Llamero/MHz_LED_Modulator_v2/MHz_LED_Driver_Software/Master list of packet data labels.txt

1-9: System identifiers
1 - ID packet
2 - temperature packet
3 - panel interface packet
4 - waveform packet

Temperature packet
byte 1 - input temp
byte 2 - output temp
byte 3 - external temp
byte 4 - Overheat state

Panel interface packet
byte 1 - potentiometer
byte 2 - toggle switch

Waveform packet
byte[] - recorded waveform

260
