Llamero/MHz_LED_Modulator_v2/Design files/Schematic.png

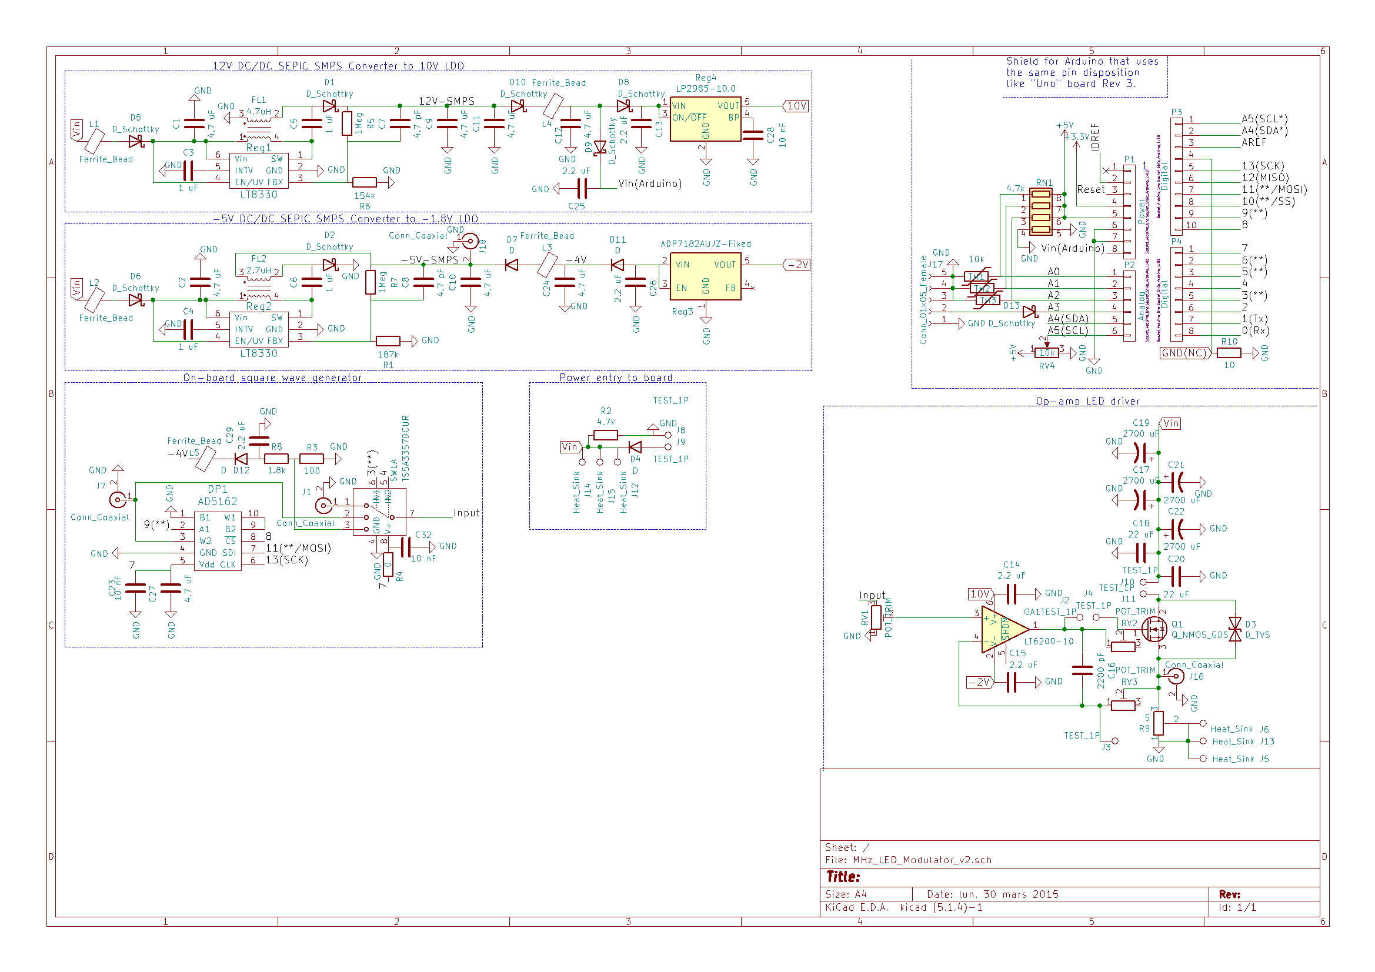
Design files/Schematic.png
