Llamero/MHz_LED_Modulator_v2/Design files/MHz_LED_Modulator_v2/MHz_LED_Modulator_v2.xlsx

Reference | Value | Footprint | Datasheet | Manufacturer | Manufacturer Part # | Digikey Part # | Count | NOTE:
J20 | GND_bolt | Wire_Pads:SolderWirePad_single_1-2mmDrill
R8 | 1.8k | Resistors_SMD:R_0603 | http://www.yageo.com/documents/recent/PYu-RT_1-to-0.01_RoHS_L_9.pdf | Yageo | RT0603DRE071K8L | 311-2472-1-ND | 1 | Â±50ppm/Â°C 0.1W Â±0.5%
C23, C28, C32 | 10 nF | Capacitors_SMD:C_0805 | http://www.samsungsem.com/kr/support/product-search/mlcc/__icsFiles/afieldfile/2016/09/21/Data%20sheet_CL21B103KDCNNNC.pdf | Samsung Electro-Mechanics | CL21B103KDCNNNC | 1276-1170-1-ND | 3 | 250V - 50MOhm resistance
D1, D2 | D_Schottky | Diodes_SMD:D_SOD-323F | https://assets.nexperia.com/documents/data-sheet/PMEG6010CEH_PMEG6010CEJ.pdf | Nexperia USA Inc. | PMEG6010CEJ,115 | 1727-3882-1-ND | 2 | Recommended
D7, D11, D12 | D | Diodes_SMD:D_SOD-323F | https://assets.nexperia.com/documents/data-sheet/BAS16_SER.pdf | Nexperia USA Inc. | BAS16J,135 | 1727-4797-1-ND | 3 | 1.25V max @ 150mA - 4ns recovery
SW1 | TS5A3357DCUR | Ben_Custom:8-VFSOP | http://www.ti.com/lit/ds/symlink/ts5a3357.pdf | Texas Instruments | TS5A3357DCUR | 296-17404-1-ND | 1 | 15 Ohm - 6.5ns switch time
Reg4 | LP2985-10.0 | TO_SOT_Packages_SMD:SOT-23-5 | http://www.ti.com/lit/ds/symlink/lp2985.pdf | Texas Instruments | LP2985-10DBVR | 296-24263-1-ND | 1 | 10V fixed - 150mA max - PSRR 45dB (1kHz)
TH1, TH2, TH3 | 10k | Ben_Custom:CC_silkscreen | http://www.cantherm.com/wp-content/uploads/2017/05/cantherm_mf52_1.pdf | Cantherm | MF52A2103J3470 | 317-1258-ND | 3 | B25/50 3470K
RV3 | POT_TRIM | Ben_Custom:Potentiometer_Trimmer_Bourns_3224W | http://www.bourns.com/docs/Product-Datasheets/3224.pdf | Bourns Inc. | 3224W-1-102E | 3224W-1-102ECT-ND | 1 | 1k Ohm Â±100ppm/Â°C 12 turns
RV2 | POT_TRIM | Ben_Custom:Potentiometer_Trimmer_Bourns_3224W | http://www.bourns.com/docs/Product-Datasheets/3224.pdf | Bourns Inc. | 3224W-1-201E | 3224W-1-201ECT-ND | 1 | 200 Ohm Â±100ppm/Â°C 12 turns
RV1 | POT_TRIM | Ben_Custom:Bourns_3313J_Trimpot-compact | http://www.bourns.com/docs/Product-Datasheets/3313.pdf | Bourns Inc. | 3313J-1-502E | 3313J-502ECT-ND | 1 | 5k Ohm
J13 | Heat_Sink | Ben_Custom:Heatsink-Wakefield_655-53AB_41x41mm | http://www.wakefield-vette.com/Portals/0/resources/datasheets/655.pdf | Wakefield-Vette | 655-53AB | 345-1093-ND | 1 | 2.00Â°C/W @ 400 LFM
J6 | Heat_Sink | Ben_Custom:40x40mm-heatsink_only-eighth-pad | https://media.digikey.com/pdf/Data%20Sheets/Wakefield%20Thermal%20PDFs/910_Series_Pin.pdf | Wakefield-Vette | 910-40-2-23-2-B-0 | 345-1161-ND | 1 | 2.00Â°C/W @ 200 LFM
C7, C8 | 4.7 pF | Capacitors_SMD:C_0603 | https://product.tdk.com/info/en/documents/chara_sheet/C1608NP01H4R7C080AA.pdf | TDK Corporation | C1608NP01H4R7C080AA | 445-14084-1-ND | 2 | 0.3Ohm ESR - 80pH ESL
C3, C4 | 1 uF | Capacitors_SMD:C_0603 | https://product.tdk.com/info/en/catalog/datasheets/mlcc_commercial_general_en.pdf | TDK Corporation | C1608X7R1A105K080AC | 445-5138-1-ND | 2 | Low ESL per spec sheet
C1, C2, C9, C10, C11, C12, C24, C27 | 4.7 uF | Capacitors_SMD:C_0805 | https://product.tdk.com/en/search/capacitor/ceramic/mlcc/info?part_no=C2012X5R1H475M125AB | TDK Corporation | C2012X5R1H475M125AB | 445-5981-1-ND | 8 | 50V max - low ESL
C16 | 2200 pF | Capacitors_SMD:C_0603 | https://psearch.en.murata.com/capacitor/product/GCM188R71H222KA37%23.pdf | Murata Electronics North America | GCM188R71H222KA37D | 490-4931-1-ND | 1 | 50V Â±10%
C18, C20 | 22 uF | Ben_Custom:2_J-lead_stacked_cap | http://psearch.en.murata.com/capacitor/product/KCM55WR71J226MH01%23.pdf | Murata Electronics North America | KCM55WR71J226MH01K | 490-5839-1-ND | 2 | 63V reverse geometry
C17, C19, C21, C22 | 2700 uF | Capacitors_THT:CP_Radial_D18.0mm_P7.50mm | http://www.chemi-con.co.jp/cgi-bin/CAT_DB/SEARCH/cat_db_al.cgi?e=e&j=p&pdfname=ky | United Chemi-Con | EKY-500ELL272MM40S | 565-1624-ND | 4 | 50V - 3.8A
C5, C6 | 1 uF | Capacitors_SMD:C_0805 | http://ds.yuden.co.jp/TYCOMPAS/ut/detail.do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 | Taiyo Yuden | HMK212BC7105KG-TE | 587-5018-1-ND | 2 | Low ESL (same as 0603) - 100V
C13, C14, C15, C25, C26, C29 | 2.2 uF | Ben_Custom:0508_Capacitor | http://ds.yuden.co.jp/TYCOMPAS/ut/detail.do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 | Taiyo Yuden | TWK212B7225MD-T | 587-5165-1-ND | 6 | Lower GHz impedance than pair of 0402 caps in SPICE
D5, D6 | D_Schottky | Ben_Custom:DO-214AC | http://www.comchiptech.com/cms/UserFiles/CDBA120SL-HF%20Thru295959.%20CDBA140SL-HF%20RevA.pdf | Comchip Technology | CDBA140SL-HF | 641-1762-1-ND | 2 | 330mV @ 1A
L3, L4, L5 | Ferrite_Bead | Inductors_SMD:L_0603 | http://katalog.we-online.de/pbs/datasheet/742863147.pdf | Wurth Electronics Inc. | 742863147 | 732-2380-1-ND | 3 | 320 mOhm - 500mA max
FL2 | 2.7uH | Ben_Custom:Wurth_Coupled_Inductor | http://katalog.we-online.de/pbs/datasheet/74489430027.pdf | Wurth Electronics Inc. | 74489430027 | 732-2590-2-ND | 1
FL1 | 4.7uH | Ben_Custom:Wurth_Coupled_Inductor | http://katalog.we-online.de/pbs/datasheet/74489440047.pdf | Wurth Electronics Inc. | 74489440047 | 732-2603-1-ND | 1
L1, L2 | Ferrite_Bead | Inductors_SMD:L_0805 | http://katalog.we-online.de/pbs/datasheet/742792097.pdf | Wurth Electronics Inc. | 742792097 | 732-4649-1-ND | 2 | 300 mOhm - 1A max
D3 | D_TVS | Ben_Custom:DO-214AC | http://katalog.we-online.de/pbs/datasheet/824501241.pdf | Wurth Electronics Inc. | 824501241 | 732-9956-1-ND | 1 | Standoff - 24V, Clamping - 38.9V - 10.3A max
R6 | 154k | Resistors_SMD:R_0603 | https://industrial.panasonic.com/cdbs/www-data/pdf/RDM0000/AOA0000C307.pdf | Panasonic Electronic Components | ERA-3AEB1543V | Â±0.1% | 1 | 25 ppm/oC
J7 | Conn_Coaxial | Symbols:OSHW-Symbol_6.7x6mm_SilkScreen | http://www.te.com/commerce/DocumentDelivery/DDEController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 | TE Connectivity AMP Connectors | 5-1634523-1 | A97548-ND | 5
DP1 | AD5162 | Housings_SSOP:MSOP-10_3x3mm_Pitch0.5mm | http://www.analog.com/media/en/technical-documentation/data-sheets/AD5162.pdf | Analog Devices Inc. | AD5162BRMZ2.5 | AD5162BRMZ2.5-ND | 1 | 35 ppm/Â°C - 35MHz SPI
Reg3 | ADP7182AUJZ-Fixed | TO_SOT_Packages_SMD:TSOT-23-5 | http://www.analog.com/media/en/technical-documentation/data-sheets/ADP7182.pdf | Analog Devices Inc. | ADP7182AUJZ-1.8-R7 | ADP7182AUJZ-1.8-R7CT-ND | 1 | Dropout max: 90mV at 50mA, 360mV at 200mA
J5, J12, J14, J15 | Heat_Sink | Ben_Custom:Heatsink-10x10mm-V2017B | http://www.assmann-wsw.com/fileadmin/datasheets/ASS_0875_HS.pdf | Assmann WSW Components | V2017B | AE10837-ND | 4 | 31.00Â°C/W @ Natural
D13 | D_Schottky | Diodes_SMD:D_SOD-323 | https://toshiba.semicon-storage.com/info/docget.jsp?did=14077&prodName=CUS10S30 | Toshiba Semiconductor and Storage | CUS10S30,H3F | CUS10S30H3FCT-ND | 1 | 230mV @ 100mA max
Q1 | Q_NMOS_GDS | Ben_Custom:IRFH5104_PQFN_5x6b | https://www.infineon.com/dgdl/irfh5104pbf.pdf?fileId=5546d462533600a40153561add341ea4 | Infineon Technologies | IRFH5104TR2PBF | IRFH5104TR2PBFCT-ND | 1 | 40V 100A 114W max - can be replaced with IRFH5006TRPBFCT-ND
OA1 | LT6200-10 | TO_SOT_Packages_SMD:SOT-23-6 | http://www.analog.com/media/en/technical-documentation/data-sheets/62001ff.pdf | Linear Technology/Analog Devices | LT6200CS6-10#TRMPBF | LT6200CS6-10#TRMPBFCT-ND | 1 | 1.6GHz GBWP - 12V Max
Reg1, Reg2 | LT8330 | TO_SOT_Packages_SMD:SOT-23-6 | http://www.analog.com/media/en/technical-documentation/data-sheets/8330fa.pdf?domain=www.linear.com | Linear Technology/Analog Devices | LT8330IS6#TRMPBF | LT8330IS6#TRMPBFCT-ND | 2
R9 | 5 | TO_SOT_Packages_SMD:TO-263-2 | http://www.caddock.com/Online_catalog/Mrktg_Lit/MP725.pdf | Caddock Electronics Inc. | MP725-5.00-1% | MP725-5.00-FCT-ND | 1 | 25W -20/ +80ppm/Â°C
R2 | 4.7k | Resistors_SMD:R_0805 | http://www.rohm.com/web/global/datasheet/ESR01MZPF/esr-e | Rohm Semiconductor | ESR10EZPJ472 | RHM4.7KKCT-ND | 1 | 0.4W - 200 ppm/oC - thick film
R4 | 0 | Resistors_SMD:R_1206 | https://www.seielect.com/Catalog/SEI-RMCF_RMCP.pdf | Stackpole Electronics Inc. | RMCF1206ZT0R00 | RMCF1206ZT0R00CT-ND | 1 | Used as jumper - 0.25W
R10 | 10 | Resistors_SMD:R_0603 | https://www.seielect.com/Catalog/SEI-rncp.pdf | Stackpole Electronics Inc. | RNCP0603FTD10R0 | RNCP0603FTD10R0CT-ND | 1 | Prevent ground loop with second ground pin
R1 | 187k | Capacitors_SMD:C_0805 | http://www.susumu.co.jp/common/pdf/n_catalog_partition05_en.pdf | Susumu | RR1220P-1873-D-M | RR12P187KDCT-ND | 1 | 25 ppm/oC Â±0.5%
J17 | Conn_01x05_Female | Socket_Strips:Socket_Strip_Straight_1x05_Pitch2.54mm | http://www.sullinscorp.com/drawings/78_P(N)PxCxxxLFBN-RC,_10492-H.pdf | Sullins Connector Solutions | PPTC051LFBN-RC | S6103-ND | 1
J1, J16 | Conn_Coaxial | Socket_Strips:Socket_Strip_Straight_1x02_Pitch2.54mm | http://www.sullinscorp.com/drawings/78_P(N)PxCxxxLFBN-RC,_10492-H.pdf | Sullins Connector Solutions | PPPC021LFBN-RC | S7035-ND | 2
D4 | D | Ben_Custom:Powerdi5060-8 | https://www.diodes.com/assets/Datasheets/SBRT20U50SLP.pdf | Diodes Incorporated | SBRT20U50SLP-13 | SBRT20U50SLP-13DICT-ND | 1 | 500mV at 20A - 50V reverse
D8, D9, D10 | D_Schottky | Diodes_SMD:D_SOD-123F | https://www.fairchildsemi.com/datasheets/SS/SS13FL.pdf | ON Semiconductor | SS13FL | SS13FLCT-ND | 3 | 6ns recovery for 100+ MHz filtering
RN1 | 4.7k | Ben_Custom:Resistor_Array_x4_1206 | https://industrial.panasonic.com/cdbs/www-data/pdf/AOC0000/AOC0000C14.pdf | Panasonic Electronic Components | EXB-38V472JV | Y9472CT-ND | 1 | Â±5% Â±200ppm/Â°C 62.5mW
R3 | 100 | Resistors_SMD:R_0603 | http://www.yageo.com/documents/recent/PYu-RT_1-to-0.01_RoHS_L_9.pdf | Yageo | RT0603FRE07100RL | YAG2320CT-ND | 1 | Â±50ppm/Â°C 0.1W Â±1%
R5, R7 | 1Meg | Resistors_SMD:R_0805 | http://www.yageo.com/documents/recent/PYu-RT_1-to-0.01_RoHS_L_9.pdf | Yageo | RT0805FRE071ML | YAG3361CT-ND | 3 | 50 ppm/oC Â±1%
J11 | TEST_1P | Wire_Pads:SolderWirePad_single_SMD_5x10mm
J2 | TEST_1P | Measurement_Points:Measurement_Point_Round-SMD-Pad_Small
J3 | TEST_1P | Measurement_Points:Measurement_Point_Round-SMD-Pad_Small
J4 | TEST_1P | Measurement_Points:Measurement_Point_Round-SMD-Pad_Small
J8 | TEST_1P | Wire_Pads:SolderWirePad_single_SMD_5x10mm
J9 | TEST_1P | Wire_Pads:SolderWirePad_single_SMD_5x10mm
P1 | Power | Socket_Arduino_Uno:Socket_Strip_Arduino_1x08
P2 | Analog | Socket_Arduino_Uno:Socket_Strip_Arduino_1x06
P3 | Digital | Socket_Arduino_Uno:Socket_Strip_Arduino_1x10
P4 | Digital | Socket_Arduino_Uno:Socket_Strip_Arduino_1x08
