Llamero/MHz_LED_Modulator_v2/Design files/MHz_LED_Modulator_v2/MHz_LED_Modulator_v2.stp

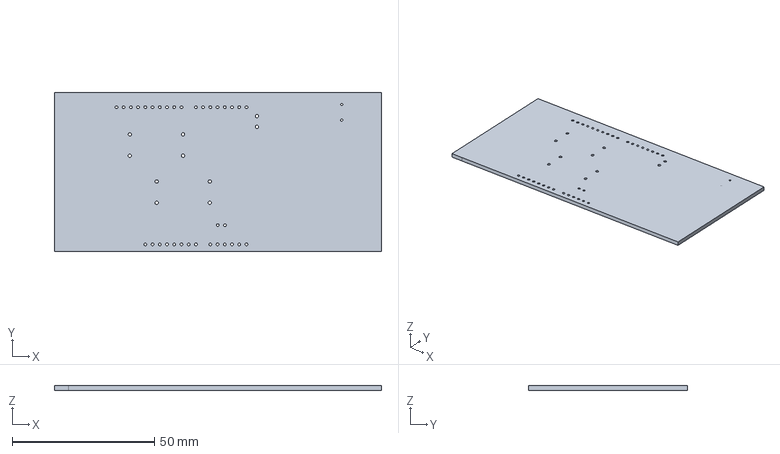
[picture p7: CAD file, 2020-05-21]
Design files/MHz_LED_Modulator_v2/MHz_LED_Modulator_v2.stp
115.0 x 56.0 x 1.60 mm
