Llamero/MHz_LED_Modulator_v2/Design files/Gerber Files - Draft 2/MHz_LED_Modulator_v2-B_SilkS.pdf

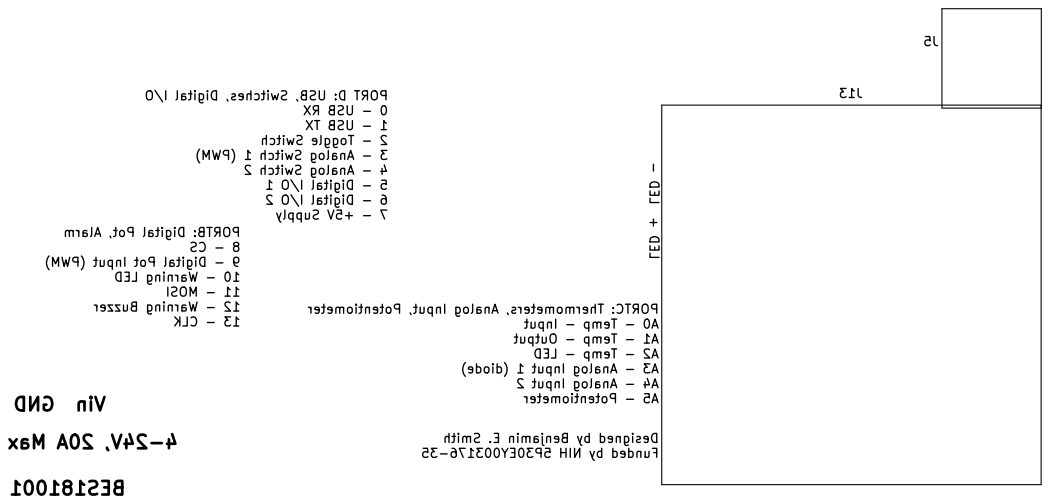
[picture p8: page 1]

Funded by NIH 5P30EY003176-35 PORT D: USB, Switches, Digital I/O

3 - Analog Switch 1 (PWM) 4 - Analog Switch 2

A3 - Analog Input 1 (diode) A4 - Analog Input 2 A5 - Potentiometer PORTB: Digital Pot, Alarm

9 - Digital Pot Input (PWM) 10 - Warning LED

11 - MOSI 12 - Warning Buzzer 13 - CLK

PORTC: Thermometers, Analog Input, Potentiometer A0 - Temp - Input A1 - Temp - Output A2 - Temp - LED

Designed by Benjamin E. Smith
