Llamero/MHz_LED_Modulator_v2/Design files/Gerber Files - Draft 2/MHz_LED_Modulator_v2-F_SilkS.pdf

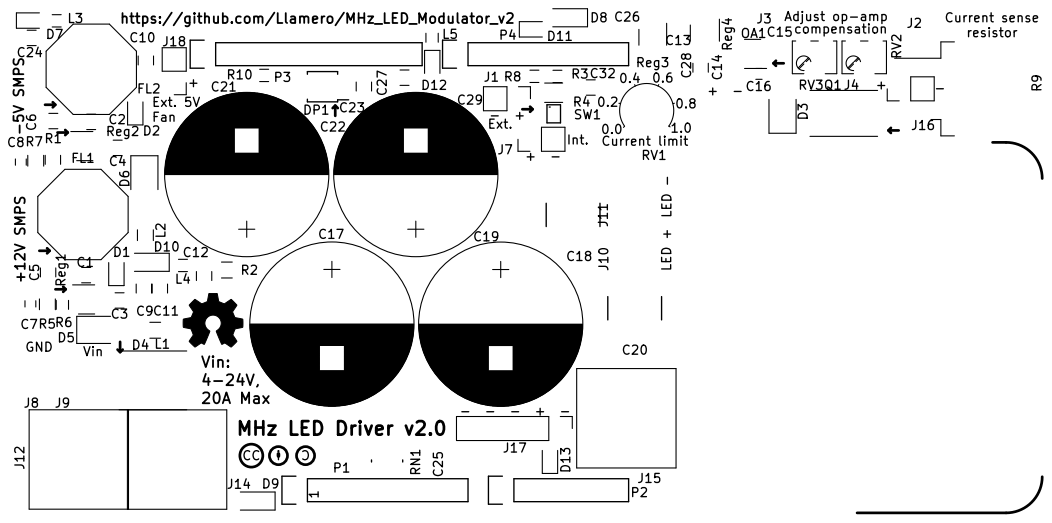
[picture p9: page 1]

resistor https://github.com/Llamero/MHz_LED_Modulator_v2 MHz LED Driver v2.0 -5V SMPS +12V SMPS
