Llamero/MHz_LED_Modulator_v2/Design files/MHz_LED_Modulator_v2/MHz_LED_Modulator_v2.pdf

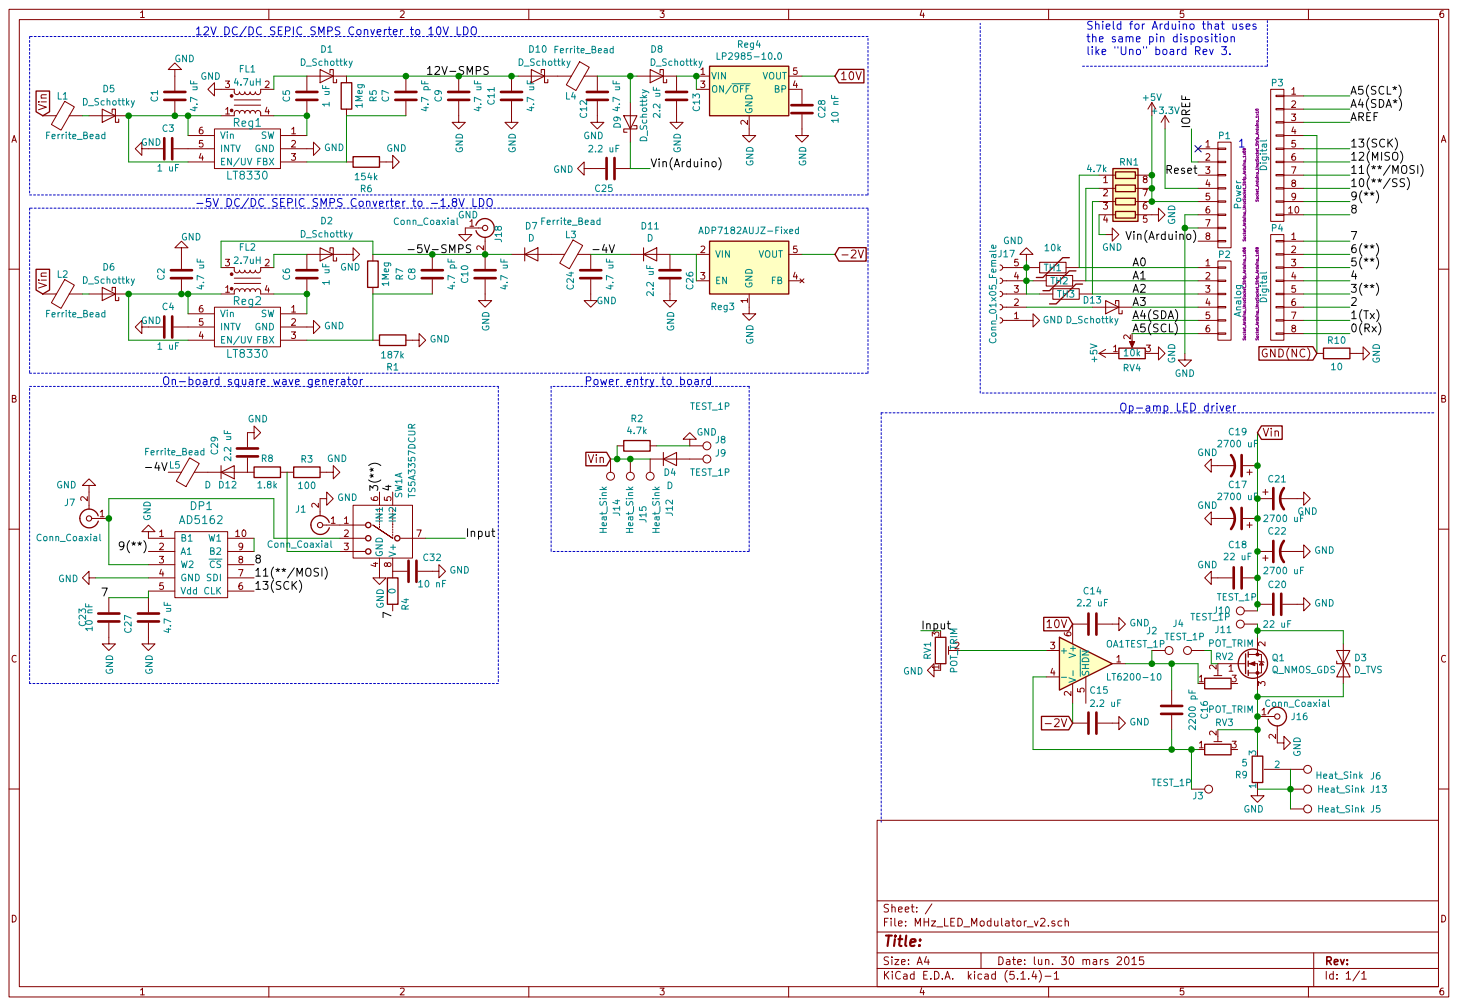
[picture p10: page 1]

Shield for Arduino that uses
the same pin disposition
like "Uno" board Rev 3.

12V DC/DC SEPIC SMPS Converter to 10V LDO

2 ON/OFF 3 BP 4 VOUT 5 Reg4

8 P1 Power Socket_Arduino_Uno:Socket_Strip_Arduino_1x08 C25
File: MHz_LED_Modulator_v2.sch Sheet: / GND

0(Rx) 1 Op-amp LED driver

-5V DC/DC SEPIC SMPS Converter to -1.8V LDO

1 VIN 2 EN 3 FB 4 VOUT 5 Reg3 ADP7182AUJZ-Fixed C6 1 uF
