Llamero/MHz_LED_Modulator_v2/Design files/Gerber Files - Draft 2/MHz_LED_Modulator_v2-B_Mask.pdf

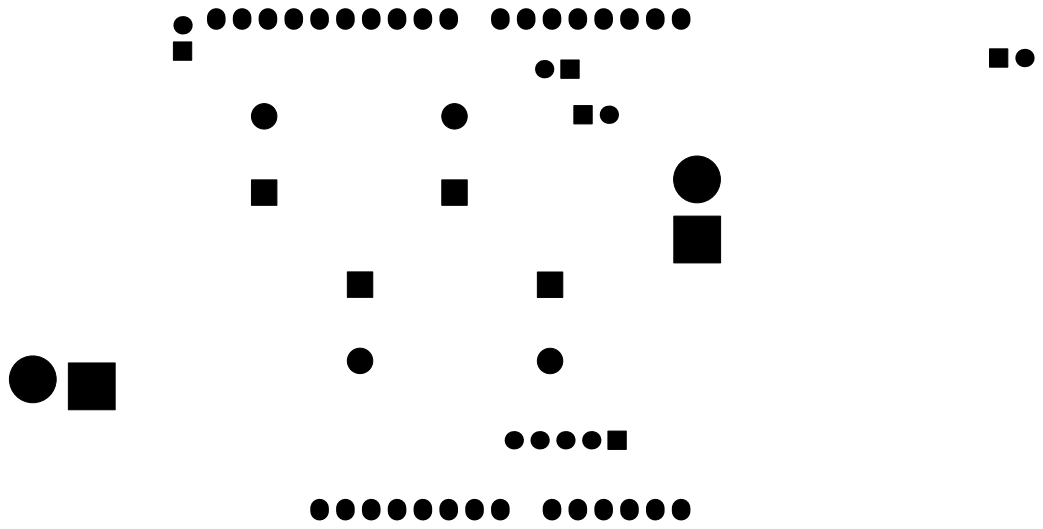
[picture p12: page 1]
