Llamero/MHz_LED_Modulator_v2/Design files/Gerber Files - Draft 2/MHz_LED_Modulator_v2-F_Cu.pdf

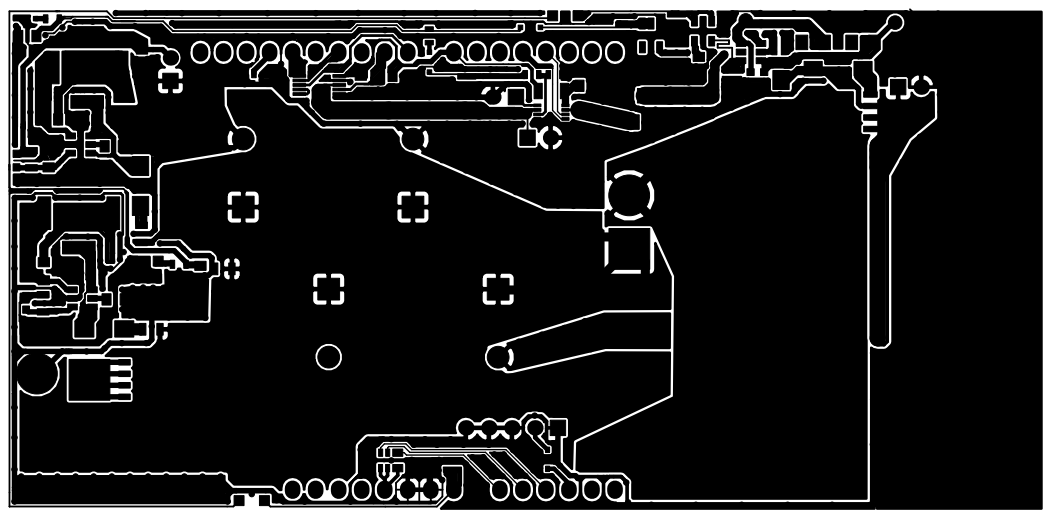
[picture p13: page 1]
