Llamero/MHz_LED_Modulator_v2/(list of files, drawings)

Other design files:
Design files/Box wiring.fzz
