Llamero/MHz_LED_Modulator_v2/Design files/MHz_LED_Modulator_v2/MHz_LED_Modulator_v2.kicad_pcb

## KiCad design Design files/MHz_LED_Modulator_v2/MHz_LED_Modulator_v2.kicad_pcb (2020-05-21)

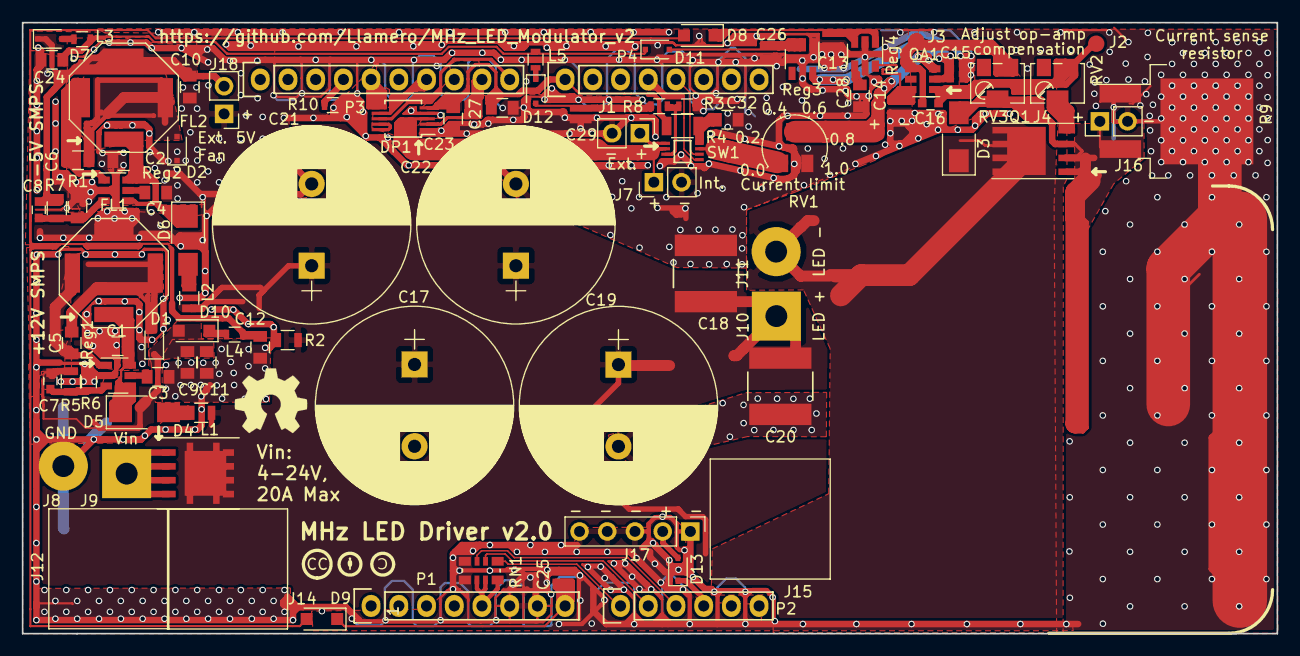
[picture p16: board MHz_LED_Modulator_v2.kicad_pcb from above]

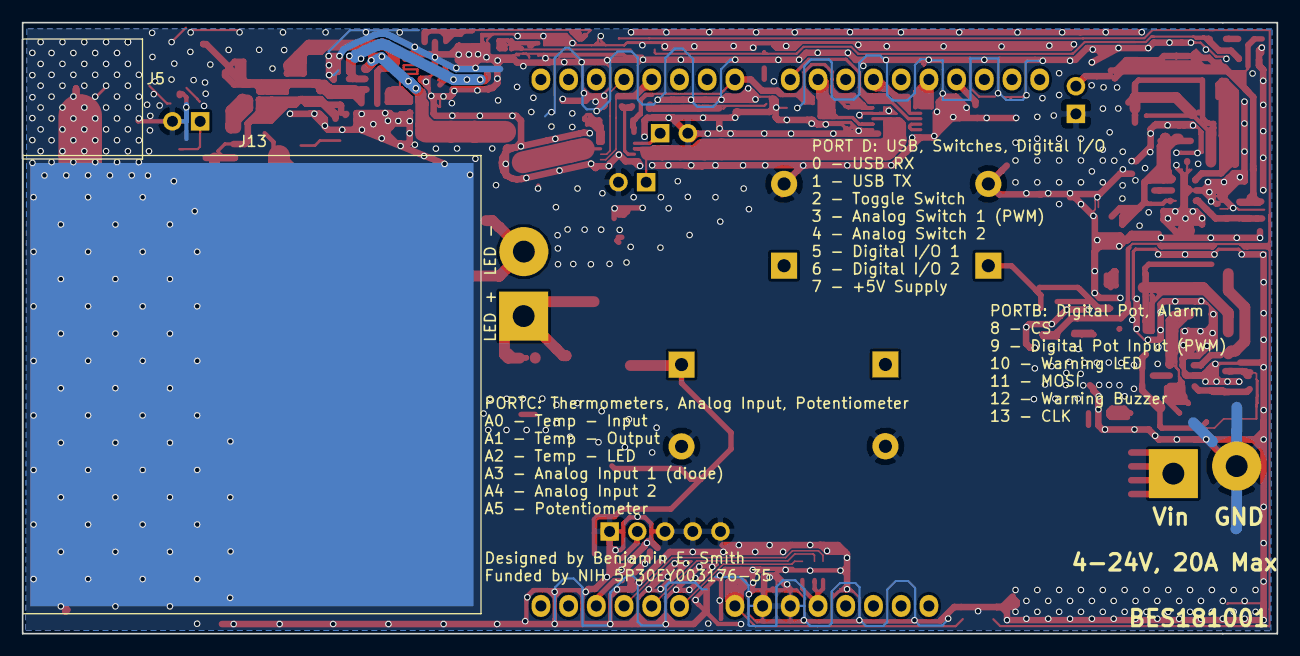
[picture p17: board MHz_LED_Modulator_v2.kicad_pcb from below]

Board: 2 copper layers, 115.0 x 56.0 mm, 98 parts (2 on the bottom side), 55 nets.

Parts:
C1, C2, C9, C10, C11, C12, C24, C27: 4.7 uF; C_0805
C3, C4, C5, C6: 1 uF; C_0805
C7, C8: 4.7 pF; C_0603
C13, C14, C15, C25, C26, C29: 2.2 uF; 0508_Capacitor
C16: 2200 pF; C_0603
C17, C19, C21, C22: 2700 uF; CP_Radial_D18.0mm_P7.50mm
C18, C20: 22 uF; 2_J-lead_stacked_cap
C23, C28, C32: 10 nF; C_0805
D1, D2: D_Schottky; D_SOD-323F
D3: D_TVS; DO-214AC
D4: D; Powerdi5060-8
D5, D6: D_Schottky; DO-214AC
D7, D11, D12: D; D_SOD-323F
D8, D9, D10: D_Schottky; D_SOD-123F
D13: D_Schottky; D_SOD-323
DP1: AD5162; MSOP-10_3x3mm_Pitch0.5mm
FL1: 4.7uH; Wurth_Coupled_Inductor
FL2: 2.7uH; Wurth_Coupled_Inductor
J1, J7, J16, J18: Conn_Coaxial; Socket_Strip_Straight_1x02_Pitch2.54mm
J2, J3, J4: TEST_1P; Measurement_Point_Round-SMD-Pad_Small
J5, J12, J14, J15: Heat_Sink; Heatsink-10x10mm-V2017B
J6: Heat_Sink; 40x40mm-heatsink_only-eighth-pad
J8, J11: TEST_1P; SolderWirePad_single_2mmDrill
J9, J10: TEST_1P; SolderWirePad_single_2mmDrill-square
J13: Heat_Sink; Heatsink-Wakefield_655-53AB_41x41mm
J17: Conn_01x05_Female; Socket_Strip_Straight_1x05_Pitch2.54mm
L1, L2: Ferrite_Bead; L_0805
L3, L4, L5: Ferrite_Bead; L_0603
OA1: LT6200-10; SOT-23-6
P1: Power; Socket_Strip_Arduino_1x08
P2: Analog; Socket_Strip_Arduino_1x06
P3: Digital; Socket_Strip_Arduino_1x10
P4: Digital; Socket_Strip_Arduino_1x08
Q1: Q_NMOS_GDS; IRFH5104_PQFN_5x6b
R1: 187k; C_0805
R2: 4.7k; R_0805
R3: 100; R_0603
R4: 0; R_1206
R5, R7: 1Meg; R_0805
R6: 154k; R_0603
R8: 1.8k; R_0603
R9: 5; Bourns_DPAK
R10: 10; R_0603
RN1: 4.7k; Resistor_Array_x4_1206
RV1: POT_TRIM; Bourns_3313J_Trimpot-compact
RV2, RV3: POT_TRIM; Potentiometer_Trimmer_Bourns_3224W
RV4: 10k; OSHW-Symbol_6.7x6mm_SilkScreen
Reg1, Reg2: LT8330; SOT-23-6
Reg3: ADP7182AUJZ-Fixed; TSOT-23-5
Reg4: LP2985-10.0; SOT-23-5
SW1: TS5A3357DCUR; 8-VFSOP
TH1: 10k; CC_silkscreen
TH2: 10k; CC_Attribution
TH3: 10k; CC_Share_alike

Connections:
10V: C14.2, OA1.6, Reg4.5
+5V: P1.5, RN1.6, RN1.7, RN1.8
-2V: C15.2, OA1.2, Reg3.5
/3(**): P4.5, SW1.6
/4: P4.4, SW1.5
/7: C23.1, C27.2, DP1.5, P4.1, R4.1
/8: DP1.8, P3.10
/9(**): DP1.2, P3.9
/11(**/MOSI): DP1.7, P3.7
/12V-SMPS: C7.2, C9.2, C11.2, D1.1, D10.2, R5.2
/13(SCK): DP1.6, P3.5
/-4V: C24.2, D11.1, L3.1, L5.1
/-5V-SMPS: C8.2, C10.2, D7.1, FL2.3, J18.2, R7.2
/A0: P2.1, RN1.1
/A1: P2.2, RN1.2
/A2: P2.3, RN1.3
/A3: D13.1, P2.4
/Input: RV1.3, SW1.7
/Vin(Arduino): C25.1, D9.1, P1.8
GND: C1.2, C2.2, C3.1, C4.1, C9.1, C10.1, C11.1, C12.1, C13.2, C14.1, C15.1, C17.2, C18.2, C19.2, C20.1, C21.2, C22.2, C23.2, C24.1, C25.2, C26.2, C27.1, C28.2, C29.1, C32.2, D2.1, DP1.1, DP1.4, FL1.3, J1.2, J5.1, J6.1, J7.2, J8.1, J13.1, J16.2, J17.1, J17.3, J17.4, J17.5, J18.1, P1.6, P1.7, R1.2, R2.1, R3.1, R6.2, R9.1, R9.2, R10.1, RN1.4, RN1.5, RV1.1, Reg1.2, Reg2.2, Reg3.1, Reg4.2, SW1.4
GND(NC): P3.4, R10.2
unnamed: C1.1, D5.1, FL1.1, Reg1.4, Reg1.6
unnamed: C2.1, D6.1, FL2.1, Reg2.4, Reg2.6
unnamed: C3.2, Reg1.5
unnamed: C4.2, Reg2.5
unnamed: C5.1, FL1.4, Reg1.1
unnamed: C5.2, D1.2, FL1.2
unnamed: C6.1, FL2.4, Reg2.1
unnamed: C6.2, D2.2, FL2.2
unnamed: C7.1, R5.1, R6.1, Reg1.3
unnamed: C8.1, R1.1, R7.1, Reg2.3
unnamed: C12.2, D8.2, D9.2, L4.1
unnamed: C13.1, D8.1, Reg4.1, Reg4.3
unnamed: C16.1, J3.1, OA1.4, RV3.1
unnamed: C16.2, J2.1, OA1.1, RV2.1
unnamed: C26.1, D11.2, Reg3.2, Reg3.3
unnamed: C28.1, Reg4.4
unnamed: C29.2, D12.2, R8.1
unnamed: C32.1, R4.2, SW1.8
unnamed: D3.1, J11.1, Q1.2
unnamed: D3.2, J16.1, Q1.3, R9.3, RV3.2
unnamed: D4.2, J9.1
unnamed: D5.2, L1.1
unnamed: D6.2, L2.1
unnamed: D7.2, L3.2
unnamed: D10.1, L4.2
unnamed: D12.1, L5.2
unnamed: D13.2, J17.2
unnamed: DP1.3, J7.1, SW1.2
unnamed: DP1.9, DP1.10
unnamed: J1.1, SW1.1
unnamed: J4.1, Q1.1, RV2.2
unnamed: OA1.3, RV1.2
unnamed: R3.2, R8.2, SW1.3
Vin: C17.1, C18.1, C19.1, C20.2, C21.1, C22.1, D4.1, J10.1, J12.1, J14.1, J15.1, L1.2, L2.2, R2.2
