Llamero/MHz_LED_Modulator_v2/(commit log)

2018-08-10 Sends byte to Arduino and then builds GUI
2018-08-23 Knob graphic is circularized. Arduino handshake and multi-arduino ID is implemented and runs on thread separate from GUI.
2018-08-24 Added radio menu option to choose which device to connect to.
2018-08-24 Cleaned up code removing arduinoPort specific SerialPort[] ,and instead just directly using serialPorts[]
2018-08-25 Switch to Eclipse
2018-08-25 Fixed problem with JFrame not closing if no COM ports were found
    [User_Interface.java]
2018-08-30 Finished temperature streaming
    The program can now parse temperature streams, and then calculate the
    temperature based off of the given beta value. The GUI has also been
    de-jittered to remove twiching temperature responses due to ADC steps
    that are larger than 1oC.
    [User_Interface.java]
2018-09-05 Framework for MVC
2018-09-06 Resolved issue where Eclipse and the compiled executable JAR look in different directories for the images. Therefore, used a con
    [Model.java]
2018-09-06 Reads and writes to Arduino!
2018-09-14 Add serial comm via interrupts
    Arduino will now incrementally check its status, send info to gui, and
    rec bytes in single increments to reduce jitter in code timing. Code
    can use interrupts in normal operation (using 1 ms clock) or use mirror
    sync as interrupt clock (i.e. check right before next sync wait.
    [Pref_and_data.java, Receive_setup_from_GUI.ino, Test_inc_status_update_timing.ino]
2018-09-15 Added initialization flow chart
2018-09-15 Initialization flow chart for both driver and GUI
2018-09-15 Initialize draft complete - untested
    Circular rx buffer is implmented, interrupt events set event flag rather
    than directly calling function (resolves issues with setting registers
    on the Arduino), failSafe now uses interrupts rather than calls to check
    status, new header structure (NEED TO UPDATE IN GUI), packet size is now
    full packet size, and check sum is sum of only data (solves issue of
    checksum possibly going to 0),.
    [Receive_setup_from_GUI.ino]
2018-10-15 Fixed circular buffer to use real mod and catch packets at very end of buffer
    [Fast_ADC_record.ino, Pref_and_data.java, Receive_setup_from_GUI.ino, Tone_test.ino]
2018-10-16 Fixed check status interupt
    Calling checkStatus in interrupt was jamming scipts that came after, so checkStatus now only flips a variable flag, allowing calls to that flag to activate check status.
    [GUI_temp_and_panel.java, Pref_and_data.java, Receive_setup_from_GUI.ino]
2018-10-16 During initialization, driver is told to hold rather than continue initialization.
2018-10-16 Disconnect funciton is cleaned up, and Arduino will now either retrieve setup (on connect) or go into standby (on initialize)
2018-10-16 Hand shake is successful GUI sends prefs to driver, and driver checks validity and replies with a the same packet.
2018-10-16 Arduino with debugged handshake
2018-10-16 Fixed bug where ID would get scrambled if other data was in buffer.
    [Pref_and_data.java]
2018-10-17 Update Arduino Test Programs/Receive_setup_from_GUI/Receive_setup_from_GUI.ino
    Fixed serial reading during check status
    The driver tx would hang on disconnect, likely because the port it was writing too was no longer available. The problem was that the Arduino would need over a second, after the port was closed to parse the incoming packet and respond. As a ll packets are critical, the circular buffer was replaced with a full read of the serial buffer on a serial event, allowing the Arduino to fully parse the disconnect command when the GUI and com port are closed.
    [Receive_setup_from_GUI.ino]
2018-10-17 Update Arduino Test Programs/Receive_setup_from_GUI/Receive_setup_from_GUI.ino
    Device now successfully goes into standby when disconnected.
2018-10-17 Fixed array copying issue When arrays are set equal, their references are equal - i.e. they become the same object and changes to one change the other. Instead, to make and independent copy, the elem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
    [GUI_temp_and_panel.java, Pref_and_data.java]
2018-10-17 Removed initial ADC reads as they do not help to reduce initial overshoot on A0
    [Receive_setup_from_GUI.ino]
2018-10-18 Status is updated while connection is made Connection sequence is also noe performed on a swingworker backgorund thread.
2018-10-18 Temp panel turns orange then red when overheating
    [GUI_temp_and_panel.java]
2018-10-18 Arduino now has digital confocal sync with 100ns jitter
    [Receive_setup_from_GUI.ino]
2018-10-20 Analog sync added - 8us jitter
    [Pref_and_data.java, Receive_setup_from_GUI.ino]
2018-10-23 Arduino now does dummy status checks on initialize to stabilize ADCs
    [Digital_pot_SPI_test.ino, Pref_and_data.java, Receive_setup_from_GUI.ino]
2018-10-25 Fan min PWM added as setup option
    min PWM needed to start fan.
2020-05-21 Add design files
    [Box wiring.fzz, MHz_LED_Modulator_v2-2019-11-12-21-44-46.sch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]
2020-07-23 Add schematic
